jbremnant/project_ledi/doc/img/intro_assembled_android.jpg

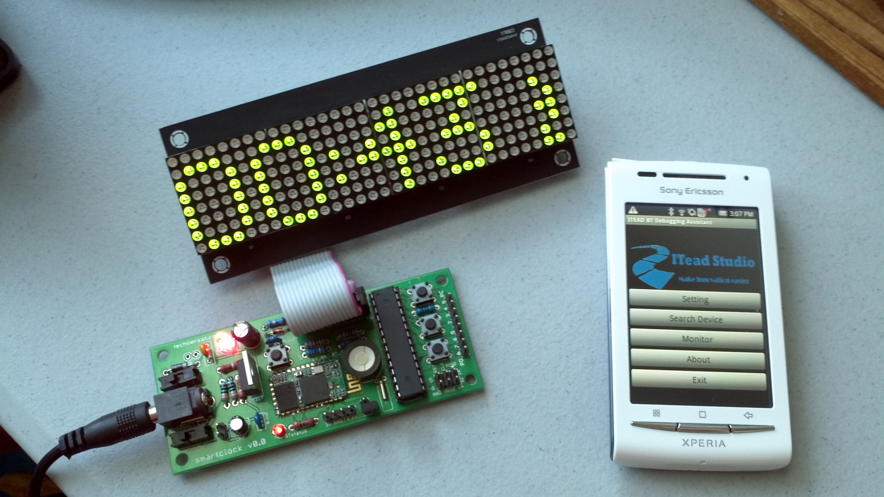
doc/img/intro_assembled_android.jpg
