jbremnant/project_ledi/doc/img/intro_pcb_assembled1.jpg

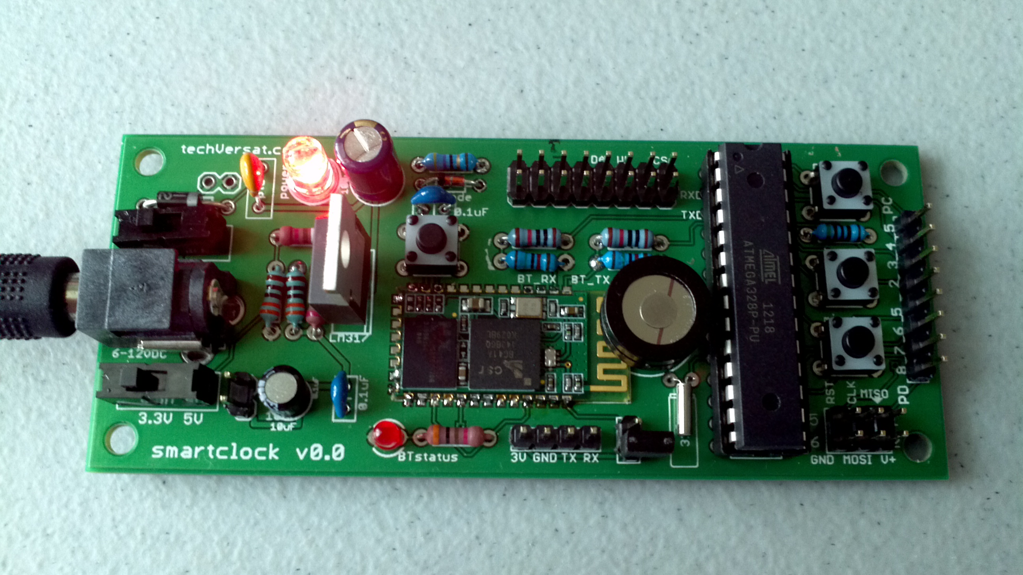
doc/img/intro_pcb_assembled1.jpg
