jbremnant/project_ledi/README.md

ledi
====

LED Interface (ledi) is an interactive LED display that can communicate with bluetooth devices as well as PC's
