jbremnant/project_ledi/doc/rst/page10_picgallery.rst

:title: LEDI Gallery
:id: 1721
:type: page
:parent_id: 1022

LEDI Gallery
============

Here are some customized LEDI enclosures we've created using LEGO blocks.
You can even print the adaptors using 3D printers to affix the PCB to the
LED matrix board.

White, Black, Gray Theme
------------------------







Office Theme
------------
With a hint of Starwars?







3D Printed Adaptors
-------------------
This was our prototype build using 3D printer.
