jbremnant/project_ledi/doc/rst/page09_takingfurther.rst

:title: 0x09 Project Ideas Using LEDI
:id: 1424
:type: page
:parent_id: 1022

0x09 Project Ideas Using LEDI
=============================

We designed LEDI to be flexible and open. We wanted to give as much control to 
the user on what and how they can modify to extend the device's functionality.
