jbremnant/project_ledi/doc/img/intro_side_by_side.jpg

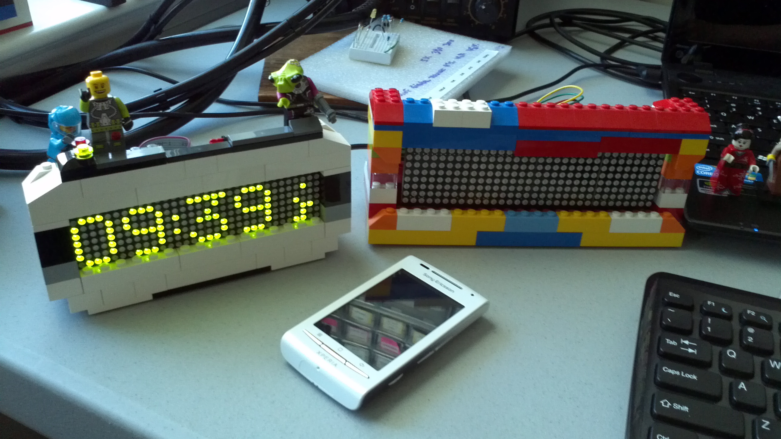
doc/img/intro_side_by_side.jpg
