jbremnant/project_ledi/doc/img/pcb_brd.png

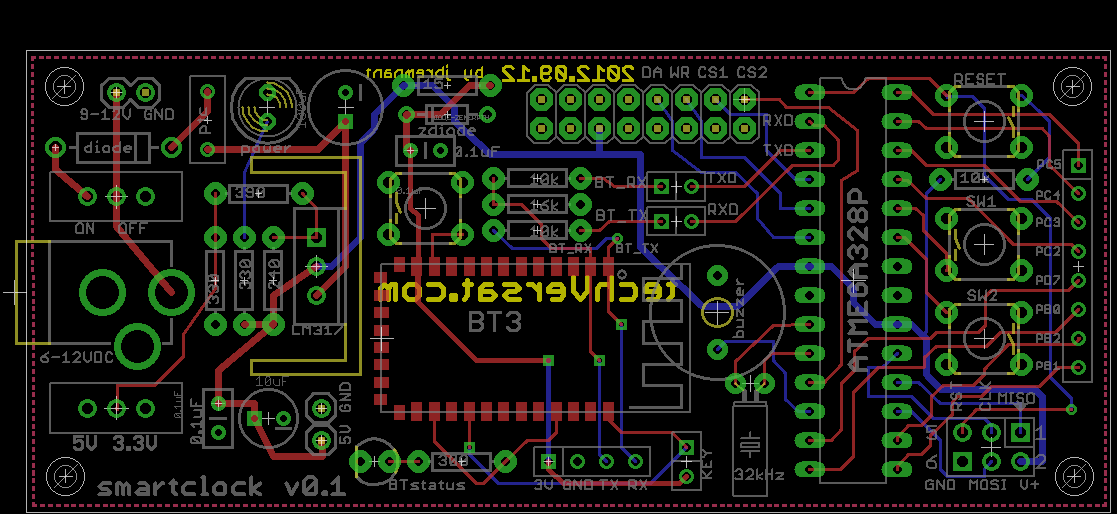
doc/img/pcb_brd.png
