jbremnant/project_ledi/doc/img/tut_pcb_close.jpg

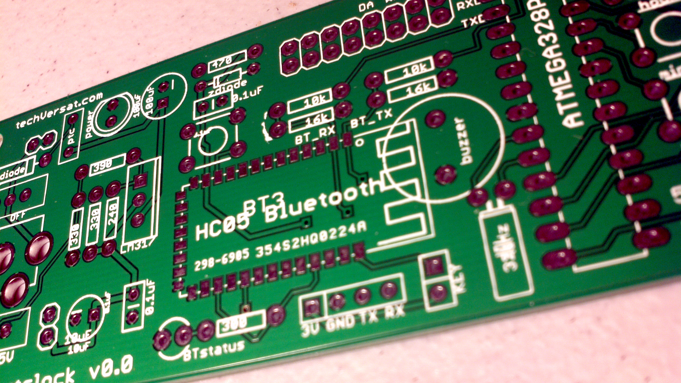
doc/img/tut_pcb_close.jpg
