jbremnant/project_ledi/doc/img/tut_parts01.jpg

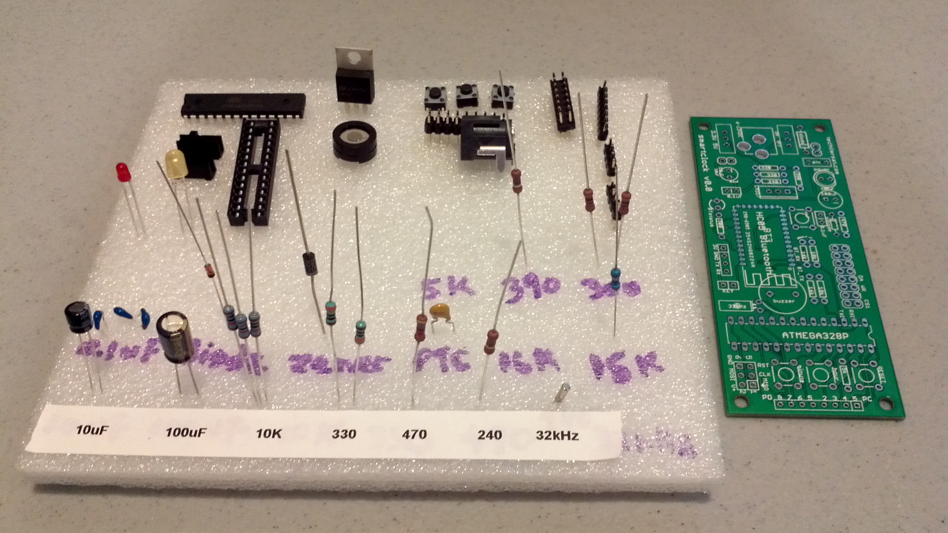
doc/img/tut_parts01.jpg
