jbremnant/project_ledi/doc/rst/page02_assembly.rst

:title: 0x02 Assembly Instructions
:id: 1400
:type: page
:parent_id: 1022

.. _`Back to top`:

0x02 Assembly Instructions
==========================

Just got your LEDI DIY kit, so what's next? 
In this page, we are going to show you:

* `What's Inside The Bag`_
* `Components Explaination`_
* `Tools Required`_
* `Soldering the Parts`_
* `Testing the Circuit`_
* `Assemblying the Acrylic Mount`_

What's Inside The Bag
----------------------



You should see the following items in your LEDI DIY kit package:

===========  =========  ==================================================  ==============
Name         Quantity   Description                                         Image
===========  =========  ==================================================  ==============
A1           1          32x8 LED matrix                                     
A2           1          Connector for LED matrix and PCB                    
B            1          `LEDI PCB`_                                         
C1,C2                   `Components List`_
C3           1          `Bluetooth module`_                                 
D            1          AC to 9V DC wall adaptor                            
===========  =========  ==================================================  ==============

Components List
~~~~~~~~~~~~~~~

=======================  =========  ==================================================  ==============
Name                     Quantity   Description                                         Image
=======================  =========  ==================================================  ==============
Atmega328p_              1          the brain of LEDI, microcontroller with 28 pins     
`28 pin DIP socket`_     1          socket for the microcontroller                      
`LDO Regulator`_         1          regulates 9VDC input into 5V or 3.3V                
`PTC resetable fuse`_    1          orange ceremic fuse .25A                            
`Crystal Oscillator`_    1          32.768KHz, silver cylinder shape                    
`Barrel jack`_           1          connector for AC adaptor                            
Slide switch             2          on/off, 3.3/5v switch                               
Tactile push button      4          buttons with 4 small legs                           
Capacitor_ 100uF         1          cylinder shape, aluminum, 2 leads                   
Capacitor_ 10uF          1          cylinder shape, aluminum, 2 leads                   
Capacitor_ 0.1uF         2          blue ceramic capacitor                              
`Zener Diode 3.3v`_      1          small orange component with black stripe            
Rectifier_ 1N4001        1          convert AC to DC current                            
Resistor_ 16k Ohms       1          ^strip colors: brown,blue,black,red                 
Resistor_ 10k Ohms       3          ^strip colors: brown,black,black,red                
Resistor_ 390 Ohms       1          ^strip colors: orange,white,brown                   
Resistor_ 330 Ohms       2          ^strip colors: orange,orange,black,black            
Resistor_ 300 Ohms       1          ^strip colors: orange,black,brown                   
Resistor_ 240 Ohms       1          ^strip colors: red,yellow,brown                     
Resistor_ 15  Ohms       1          ^strip colors: brown,green,black,gold               
LED_ Red                 1          red LED                                             
LED_ Amber               1          oval shape amber LED                                
Piezo Buzzer             1          makes sounds                                        
Header Single row        1          12 pins single row headers for breakout pins        
Header Dual row          1          2 x 15 header for connecting ribbon cable           
=======================  =========  ==================================================  ==============

.. _`Bluetooth module`: http://imall.iteadstudio.com/prototyping/basic-module/im120723009.html
.. _Atmega328p: http://www.atmel.com/devices/atmega328p.aspx
.. _`28 pin DIP socket`: http://en.wikipedia.org/wiki/Dual_in-line_package
.. _`LDO Regulator`: http://en.wikipedia.org/wiki/Low-dropout_regulator
.. _`PTC resetable fuse`: http://en.wikipedia.org/wiki/Resettable_fuse
.. _`Crystal Oscillator`: http://en.wikipedia.org/wiki/Crystal_oscillator
.. _`Barrel jack`: https://www.sparkfun.com/products/119

Resistors may come in different color and number of stripes depending on manufacturer,
the strip color specified above only indicates the resistor value portion.
Refer to the Resistor_ section to understand how to read the stripes value.

**If you are purchasing the acrylic mount**, the package should also include:

======================  =========  ==================================================  ==============
Name                    Quantity   Description                                         Image
======================  =========  ==================================================  ==============
Spacer 1/8"             4          1/8" length nylon spacers                           
Spacer 1/4"             4          2/8" length nylon spacers                           
Spacer 3/4"             4          6/8" length nylon spacers                           
Screw 1-1/2"            4          1-1/2" stainless steel screw                        
Screw 5/8               4          5/8" stainless steel screw                          
Nuts 4-40 thread        8          4-40 thread stainless steel hex nuts                
Acrylic front plate     1          Transparent acrylic plate for front cover           
Acrylic adaptor plate   2          Transparent acrylic adaptor                         
======================  =========  ==================================================  ==============

`Back to top`_

.. _Capacitor:

Components Explaination
-----------------------

Before assembly, let's make sure we have sufficient understanding about the components
used in this project, understanding this section will ensure successful completion of your build.

#. **Electrolytic Capacitor** (`wiki capacitor <http://en.wikipedia.org/wiki/Electrolytic_capacitor>`_)

    They look like aluminum cylinders wrapped in black plastic with one short and
   one long leg. Please note that **ORIENTATION MATTERS** while you are placing the component on the PCB. 
   **The short leg is the negative (-) terminal**. This negative terminal
   is also indicated on the plastic covering. The plastic cover will have a strip going
   down on the negative terminal side. In our design, negative terminal connects to GROUND.

.. _Rectifier:

#. **Reverse Voltage Protection Diode** (`wiki diode <http://en.wikipedia.org/wiki/Diode>`_) (`wiki rectifier <http://en.wikipedia.org/wiki/Rectifier>`_)

    This part looks like a small black cynlinder. It allows current to flow in one
   direction and not in the other. In this project, we are using the popular 1.0A
   general purpose silion rectifier diode - 1N4001, which serves as converter from AC to DC
   current. **ORIENTATION MATTERS** for all diodes. A small white strip on one end indicates the blocking side. 
   You will need to look at the PCB carefully and make sure the side with the strip is properly 
   aligned with the indicated strip on the PCB silkscreen (white labels on PCB).

.. _`Zener Diode 3.3v`:

#. **Zener Diode 3.3v** (`wiki zener diode <http://en.wikipedia.org/wiki/Zener_diode>`_)

    This part also looks like a cylinder, but in orange. It is similar to the diode
   described above, but allows current to flow in the reverse direction when the
   voltage is above a certain value. Therefore the **ORIENTATION MATTERS** for this component too.
   The black strip on one end indicates the "blocking" side. You will need to carefully match 
   this strip with the PCB silkscreen.

.. _LED:

#. **LED** (`light-emitting diode <http://en.wikipedia.org/wiki/LED>`_)

    One of the most common parts you can find in electronic kits or even at your
   local RadioShack, this part also has two legs - one short, one long. The short leg is the
   (-) terminal. Make sure the shorter leg connects to GROUND.

.. _Resistor:

#. **Resistor** (`wiki resistor <http://en.wikipedia.org/wiki/Resistor>`_)

    You will need to be careful about getting the resistor values right.
   Unlike other components discussed, the **orientation does NOT matter.** You can stick
   in the resistor in either direction onto the PCB. 
   Refer to the following resistor color code to determine their value:

   

   For example, if you see `red - yellow - black - orange`, you can read

::

    red   yellow  black  orange
      2        4      0      1k   ==  240k

Beside reading the color directly, it is always good to have a multimeter 
handy to measure the exact resistance. 

`Back to top`_

Tools Required
---------------

OK, now that you understanding the major components going into LEDI, let's talk about 
tools that you would need:

====================================  ====================
Tool                                  The Look
====================================  ====================
1. soldering_ iron                    
2. solder_ (Lead free preferable)     
3. flux_ (good to have)               
4. digital multimeter_ (optional)     
5. wire cutter_                       
6. solder wick_  (optional)           
7. solder sucker_ (optional)          
====================================  ====================

.. _flux: https://www.sparkfun.com/products/8967
.. _solder: https://www.sparkfun.com/products/9325
.. _soldering: http://www.adafruit.com/category/8_84
.. _multimeter: https://www.sparkfun.com/products/9141
.. _cutter: http://www.adafruit.com/products/152
.. _wick: http://www.adafruit.com/products/149
.. _sucker: http://www.adafruit.com/products/148

The flux, solder wick, and solder sucker are optional. However, they are good
tools to help ammend mistakes. If you are soldering for the first time, we
highly recommend getting those as well.

Here are the steps we will take

#. Organize the parts
#. Solder
#. Test the circuit
#. Install the app
#. Play with it!

If you've never soldered before, it might be good to do some prep reading or
even prep practice before you go into touching the components. It's easy to solder but 
hard to take out sometime.
There are lots of great videos and tutorials online. Here are few:

* `Sparkfun tutorial <http://www.sparkfun.com/tutorials/106>`_.
* `Adafruit tutorial <http://www.ladyada.net/learn/soldering/thm.html>`_.
* `Soldering tutorial at aaroncake.net <http://www.aaroncake.net/electronics/solder.htm>`_

`Back to top`_

Soldering the Parts
-------------------

Through-hole soldering is pretty fun and straight forward! Make sure you work in a well ventilated room.
Now, all you need is some solder and a soldering iron. When we are done with the
assembly, your LEDI board will look like this:



The parts are easier to find once you organize them. It's good to label similar
looking parts beforehand, so you know exactly which part you are going to solder.
For example, here's how I organized the parts before soldering.



It's good to complete similar parts of the circuit and then move onto the next. 
This way, you can make sure you got all the parts soldered in the right place,
instead of jumping around the circuit. (not literally!)

.. _`LEDI PCB`:

LEDI circuit can be roughly divided into 4 sections. We will complete each section
at a time before moving onto the next. 



You will soon see that soldering LEDI board is easy and straight-forward.

Power supply circuit
~~~~~~~~~~~~~~~~~~~~
You will need to be careful about the polarity of the electrolyte capacitors.
The shorter leg is the negative side. It's this shorter leg that will connect
to ground. The same goes for the power indicator LED. The shorter leg connects
to the ground through-hole, which is denoted with a minus "-" sign.



Here's how I placed the parts before soldering. Notice the legs are bent on the
other side of the PCB so that they are held stationary as I solder them permanently
in place.



Bluetooth module
~~~~~~~~~~~~~~~~
The bluetooth module is the hardest part to solder. You will find that the rest of
what follows is a breeze. First place the bluetooth module on the PCB.
You will solder just one pad on each side first. This will hold the module in place.

You will only need to solder 11 joints on the module. The rest of the pads does not need 
to be soldered. Those 11 joints are indicated by orange circle below:



If you have the flux handy, it helps the solder to flow onto the pads easily.
You can use it to "tin" the pads by

#. applying little bit of flux onto the PCB pads
#. put some solder on the soldering iron, and gently pass it over the pads

At this point, the solder will flow to the pads and settle. Once the pads are tinned
with solder, you can simply set the bluetooth module on top, and touch the pad to
reflow the solder onto the bluetooth connection grooves.

Once the bluetooth module is soldered, solder the indicator LED and resistors 
around the bluetooth module. The headers are optional, unless you plan to hack around
with LEDI later on.

Zener diode voltage regulator circuit 
~~~~~~~~~~~~~~~~~~~~~~~~~~~~~~~~~~~~~
It's crucial to get the resistor value right here. You will need 15 Ohm (not 15k!!!)
resistor, a zener diode, and a 0.1uF capacitor. As a reminder, resistor strip colors are::
     
      1     5    0x  tolerance  ==  15 ohm
  brown green black  gold

The zener diode need special attention as well. Make sure you align the black strip
side with the side that has white line on the PCB. It should look like the following picture.



You can then add the push button that will allow you to reset the bluetooth module.
Optionally, you can add the headers that will give you access to the bluetooth module's UART ports.

After this circuit is built, you are ready to do your first test! Simply plug in the 9V
power adaptor to the wall, and connect the barrel jack to the board. Take a deep breath
and turn the switch to "on" position!

Do you see the power LED light up and the indicator LED near the bluetooth module
blinking? If so, you are on your way to getting it successfully built!
If not, you will need to check your components and make sure you soldered the
parts correctly.

Atmega328p microcontroller and headers
~~~~~~~~~~~~~~~~~~~~~~~~~~~~~~~~~~~~~~
This is the easiest part of the circuit. You have one pull up resistor (10k ohm), 3 buttons,
watch crystal (32.768kHz) and IC socket. The microcontroller will be inserted into the IC
socket once everything is soldered in place.



The 2x3 header on the bottom right corner is a must if you plan on flashing the firmware.
By default, LEDI will come preloaded with the most recent firmware. However, if you plan
on doing firmware development and modify functionality, solder the 2x3 header there.

Also, the 1x8 header gives you access to unused I/O pins on the microcontroller. Solder this
too if you want to make LEDI interface with other electronics.

`Back to top`_

Testing the Circuit
-------------------

Now you are finally ready to test the whole thing!
Let's first connect the LED matrix to the circuit board.

Note that the ribbon cable has a red strip on one end. The red strip denotes the first pin.
Align this with the pin labelled CS1 on the circuit board.
The PCB side of the ribbon cable connection looks like this:



Don't mind the other device on the picture right now (`little wire <http://littlewire.cc/>`_) -
this device can help flash the firmware of LEDI.

Connect the other side of the ribbon cable to the LED matrix. Make sure your DIP switch on the
LED matrix board looks like this:

.. leesa, picture of the 1,2,3,4 switch on the backside of LED board

Once connected, time to power it on!
Connect the included 9VDC adaptor to the barrel jack, and plug it to the wall outlet.
Now, take a deep breath again and switch the power to **on**.
Did you see the sign "LEDI" on the LED matrix board? If so, congratulations!
You have successfully assembled LEDI.

There's so much more to play around with. Check out our other tutorials to explore many
exciting projects with LEDI.

Assemblying the Acrylic Mount
-----------------------------
Now that the PCB and LED matrix work well, time to put a little cosmetic on it. Depending on your personl preference, you can 

#. Just leave the parts on your desk.
#. Put the parts together with our customed made acrylic mount.
#. Use bricks to make the LEDI into a piece of artwork. 
#. Or even print your own mount or enclosure if you have a 3D printer.

If you opt to use our customed made acrylic mount, here's the detail instruction for the assembly.

`Back to top`_





























 
.. parts list

   :uploaded-scale10: http://techversat.com/wp-content/uploads/ledi/parts_ledi_MCU-scale10.jpg
   :uploaded: http://techversat.com/wp-content/uploads/ledi/parts_ledi_MCU.jpg
   :width: 1000
   :scale: 10

   :uploaded-scale10: http://techversat.com/wp-content/uploads/ledi/parts_ledi_DIPSocket-scale5.jpg
   :uploaded: http://techversat.com/wp-content/uploads/ledi/parts_ledi_DIPSocket.jpg
   :width: 1000
   :scale: 10

   :uploaded-scale10: http://techversat.com/wp-content/uploads/ledi/parts_ledi_PCB-v1-scale10.jpg
   :uploaded: http://techversat.com/wp-content/uploads/ledi/parts_ledi_PCB-v1.jpg
   :width: 1000
   :scale: 10

   :uploaded-scale10: http://techversat.com/wp-content/uploads/ledi/parts_ledi_BTModule-scale10.jpg
   :uploaded: http://techversat.com/wp-content/uploads/ledi/parts_ledi_BTModule.jpg
   :width: 1000
   :scale: 10

   :uploaded-scale10: http://techversat.com/wp-content/uploads/ledi/parts_ledi_VRegulator-scale10.jpg
   :uploaded: http://techversat.com/wp-content/uploads/ledi/parts_ledi_VRegulator.jpg
   :width: 1000
   :scale: 10

   :uploaded-scale10: http://techversat.com/wp-content/uploads/ledi/parts_ledi_PTC-scale10.jpg
   :uploaded: http://techversat.com/wp-content/uploads/ledi/parts_ledi_PTC.jpg
   :width: 1000
   :scale: 10

   :uploaded-scale10: http://techversat.com/wp-content/uploads/ledi/parts_ledi_Crystal-scale10.jpg
   :uploaded: http://techversat.com/wp-content/uploads/ledi/parts_ledi_Crystal.jpg
   :width: 1000
   :scale: 10

   :uploaded-scale10: http://techversat.com/wp-content/uploads/ledi/parts_ledi_BarrelJack-scale10.jpg
   :uploaded: http://techversat.com/wp-content/uploads/ledi/parts_ledi_BarrelJack1.jpg
   :width: 1000
   :scale: 10

   :uploaded-scale10: http://techversat.com/wp-content/uploads/ledi/parts_ledi_SlideSwitch-scale10.jpg
   :uploaded: http://techversat.com/wp-content/uploads/ledi/parts_ledi_SlideSwitch.jpg
   :width: 1000
   :scale: 10

   :uploaded-scale10: http://techversat.com/wp-content/uploads/ledi/parts_ledi_ButtonSwitch-scale10.jpg
   :uploaded: http://techversat.com/wp-content/uploads/ledi/parts_ledi_ButtonSwitch.jpg
   :width: 1000
   :scale: 10

   :uploaded-scale10: http://techversat.com/wp-content/uploads/ledi/parts_ledi_Capacitor-100uF-scale10.jpg
   :uploaded: http://techversat.com/wp-content/uploads/ledi/parts_ledi_Capacitor-100uF.jpg
   :width: 1000
   :scale: 10

   :uploaded-scale10: http://techversat.com/wp-content/uploads/ledi/parts_ledi_Capacitor-10uF-scale10.jpg
   :uploaded: http://techversat.com/wp-content/uploads/ledi/parts_ledi_Capacitor-10uF.jpg
   :width: 1000
   :scale: 10

   :uploaded-scale10: http://techversat.com/wp-content/uploads/ledi/parts_ledi_Capacitor-0.1uF-scale10.jpg
   :uploaded: http://techversat.com/wp-content/uploads/ledi/parts_ledi_Capacitor-0.1uF.jpg
   :width: 1000
   :scale: 10

   :uploaded-scale10: http://techversat.com/wp-content/uploads/ledi/parts_ledi_Zener-3.3V-scale10.jpg
   :uploaded: http://techversat.com/wp-content/uploads/ledi/parts_ledi_Zener-3.3V.jpg
   :width: 1000
   :scale: 10

   :uploaded-scale10: http://techversat.com/wp-content/uploads/ledi/parts_ledi_1N4001-scale10.jpg
   :uploaded: http://techversat.com/wp-content/uploads/ledi/parts_ledi_1N4001.jpg
   :width: 1000
   :scale: 10

   :uploaded-scale10: http://techversat.com/wp-content/uploads/ledi/parts_ledi_Resistor-16KOhm-scale10.jpg
   :uploaded: http://techversat.com/wp-content/uploads/ledi/parts_ledi_Resistor-16KOhm.jpg
   :width: 1000
   :scale: 10

   :uploaded-scale10: http://techversat.com/wp-content/uploads/ledi/parts_ledi_Resistor-10KOhm-scale10.jpg
   :uploaded: http://techversat.com/wp-content/uploads/ledi/parts_ledi_Resistor-10KOhm.jpg
   :width: 1000
   :scale: 10

   :uploaded-scale10: http://techversat.com/wp-content/uploads/ledi/parts_ledi_Resistor-390Ohm-scale10.jpg
   :uploaded: http://techversat.com/wp-content/uploads/ledi/parts_ledi_Resistor-390Ohm.jpg
   :width: 1000
   :scale: 10

   :uploaded-scale10: http://techversat.com/wp-content/uploads/ledi/parts_ledi_Resistor-330Ohm-scale10.jpg
   :uploaded: http://techversat.com/wp-content/uploads/ledi/parts_ledi_Resistor-330Ohm.jpg
   :width: 1000
   :scale: 10

   :uploaded-scale10: http://techversat.com/wp-content/uploads/ledi/parts_ledi_Resistor-300Ohm-scale10.jpg
   :uploaded: http://techversat.com/wp-content/uploads/ledi/parts_ledi_Resistor-300Ohm.jpg
   :width: 1000
   :scale: 10

   :uploaded-scale10: http://techversat.com/wp-content/uploads/ledi/parts_ledi_Resistor-240Ohm-scale10.jpg
   :uploaded: http://techversat.com/wp-content/uploads/ledi/parts_ledi_Resistor-240Ohm.jpg
   :width: 1000
   :scale: 10

   :uploaded-scale10: http://techversat.com/wp-content/uploads/ledi/parts_ledi_Resistor-15Ohm-scale10.jpg
   :uploaded: http://techversat.com/wp-content/uploads/ledi/parts_ledi_Resistor-15Ohm.jpg
   :width: 1000
   :scale: 10

   :uploaded-scale10: http://techversat.com/wp-content/uploads/ledi/parts_ledi_LED-Yellow-scale10.jpg
   :uploaded: http://techversat.com/wp-content/uploads/ledi/parts_ledi_LED-Yellow.jpg
   :width: 1000
   :scale: 10

   :uploaded-scale10: http://techversat.com/wp-content/uploads/ledi/parts_ledi_LED-Red-scale10.jpg
   :uploaded: http://techversat.com/wp-content/uploads/ledi/parts_ledi_LED-Red.jpg
   :width: 1000
   :scale: 10

   :uploaded-scale10: http://techversat.com/wp-content/uploads/ledi/parts_ledi_Buzz-scale10.jpg
   :uploaded: http://techversat.com/wp-content/uploads/ledi/parts_ledi_Buzz.jpg
   :width: 1000
   :scale: 10

   :uploaded-scale10: http://techversat.com/wp-content/uploads/ledi/parts_ledi_WallAdaptor-AC-9VDC-scale10.jpg
   :uploaded: http://techversat.com/wp-content/uploads/ledi/parts_ledi_WallAdaptor-AC-9VDC.jpg
   :width: 1000
   :scale: 10

   :uploaded-scale10: http://techversat.com/wp-content/uploads/ledi/parts_ledi_SingleHeader-scale10.jpg
   :uploaded: http://techversat.com/wp-content/uploads/ledi/parts_ledi_SingleHeader.jpg
   :width: 1000
   :scale: 10

   :uploaded-scale10: http://techversat.com/wp-content/uploads/ledi/parts_ledi_DualHeader-scale10.jpg
   :uploaded: http://techversat.com/wp-content/uploads/ledi/parts_ledi_DualHeader.jpg
   :width: 1000
   :scale: 10

   :uploaded-scale10: http://techversat.com/wp-content/uploads/ledi/parts_ledi_LEDMatrix-32x8-scale10.jpg
   :uploaded: http://techversat.com/wp-content/uploads/ledi/parts_ledi_LEDMatrix-32x8.jpg
   :width: 1000
   :scale: 10

   :uploaded-scale10: http://techversat.com/wp-content/uploads/ledi/parts_ledi_Connector-LEDMatrix-PCB-scale10.jpg
   :uploaded: http://techversat.com/wp-content/uploads/ledi/parts_ledi_Connector-LEDMatrix-PCB.jpg
   :width: 1000
   :scale: 10

   :uploaded-scale10: http://techversat.com/wp-content/uploads/ledi/parts_lediAcrylic_Spacer-1-4-scale10.jpg
   :uploaded: http://techversat.com/wp-content/uploads/ledi/parts_lediAcrylic_Spacer-1-4.jpg
   :width: 1000
   :scale: 10

   :uploaded-scale10: http://techversat.com/wp-content/uploads/ledi/parts_lediAcrylic_Spacer-1-8-scale10.jpg
   :uploaded: http://techversat.com/wp-content/uploads/ledi/parts_lediAcrylic_Spacer-1-8.jpg
   :width: 1000
   :scale: 10

   :uploaded-scale10: http://techversat.com/wp-content/uploads/ledi/parts_lediAcrylic_Spacer-3-4-scale10.jpg
   :uploaded: http://techversat.com/wp-content/uploads/ledi/parts_lediAcrylic_Spacer-3-4.jpg
   :width: 1000
   :scale: 10

   :uploaded-scale10: http://techversat.com/wp-content/uploads/ledi/parts_lediAcrylic_Screw-1.5-scale10.jpg
   :uploaded: http://techversat.com/wp-content/uploads/ledi/parts_lediAcrylic_Screw-1.5.jpg
   :width: 1000
   :scale: 10

   :uploaded-scale10: http://techversat.com/wp-content/uploads/ledi/parts_lediAcrylic_Screw-5-8-scale10.jpg
   :uploaded: http://techversat.com/wp-content/uploads/ledi/parts_lediAcrylic_Screw-5-8.jpg
   :width: 1000
   :scale: 10

   :uploaded-scale10: http://techversat.com/wp-content/uploads/ledi/parts_lediAcrylic_Nut-4-40-scale10.jpg
   :uploaded: http://techversat.com/wp-content/uploads/ledi/parts_lediAcrylic_Nut-4-40.jpg
   :width: 1000
   :scale: 10

   :uploaded-scale10: http://techversat.com/wp-content/uploads/ledi/parts_lediAcrylic_FrontCover-scale10.jpg
   :uploaded: http://techversat.com/wp-content/uploads/ledi/parts_lediAcrylic_FrontCover.jpg
   :width: 1000
   :scale: 10

   :uploaded-scale10: http://techversat.com/wp-content/uploads/ledi/parts_lediAcrylic_Adaptor-scale10.jpg
   :uploaded: http://techversat.com/wp-content/uploads/ledi/parts_lediAcrylic_Adaptor.jpg
   :width: 1000
   :scale: 10

   :uploaded-scale10: http://techversat.com/wp-content/uploads/ledi/parts_ledi_Capacitor-100uF-scale10.jpg
   :uploaded: http://techversat.com/wp-content/uploads/ledi/parts_ledi_Capacitor-100uF.jpg
   :scale: 10

   :uploaded-scale10: http://techversat.com/wp-content/uploads/ledi/parts_ledi_1N4001-scale10.jpg
   :uploaded: http://techversat.com/wp-content/uploads/ledi/parts_ledi_1N4001.jpg
   :scale: 10

   :uploaded-scale10: http://techversat.com/wp-content/uploads/ledi/parts_ledi_Zener-3.3V-scale10.jpg
   :uploaded: http://techversat.com/wp-content/uploads/ledi/parts_ledi_Zener-3.3V.jpg
   :scale: 10

   :uploaded-scale10: http://techversat.com/wp-content/uploads/ledi/parts_ledi_LED-Red-scale10.jpg
   :uploaded: http://techversat.com/wp-content/uploads/ledi/parts_ledi_LED-Red.jpg
   :scale: 10

   :uploaded-scale10: http://techversat.com/wp-content/uploads/ledi/parts_ledi_Resistor-15Ohm-scale10.jpg
   :uploaded: http://techversat.com/wp-content/uploads/ledi/parts_ledi_Resistor-15Ohm.jpg
   :scale: 10
