jbremnant/project_ledi/hw/v0.0/sc_v0.brd

## EAGLE design hw/v0.0/sc_v0.brd (2012-11-04)

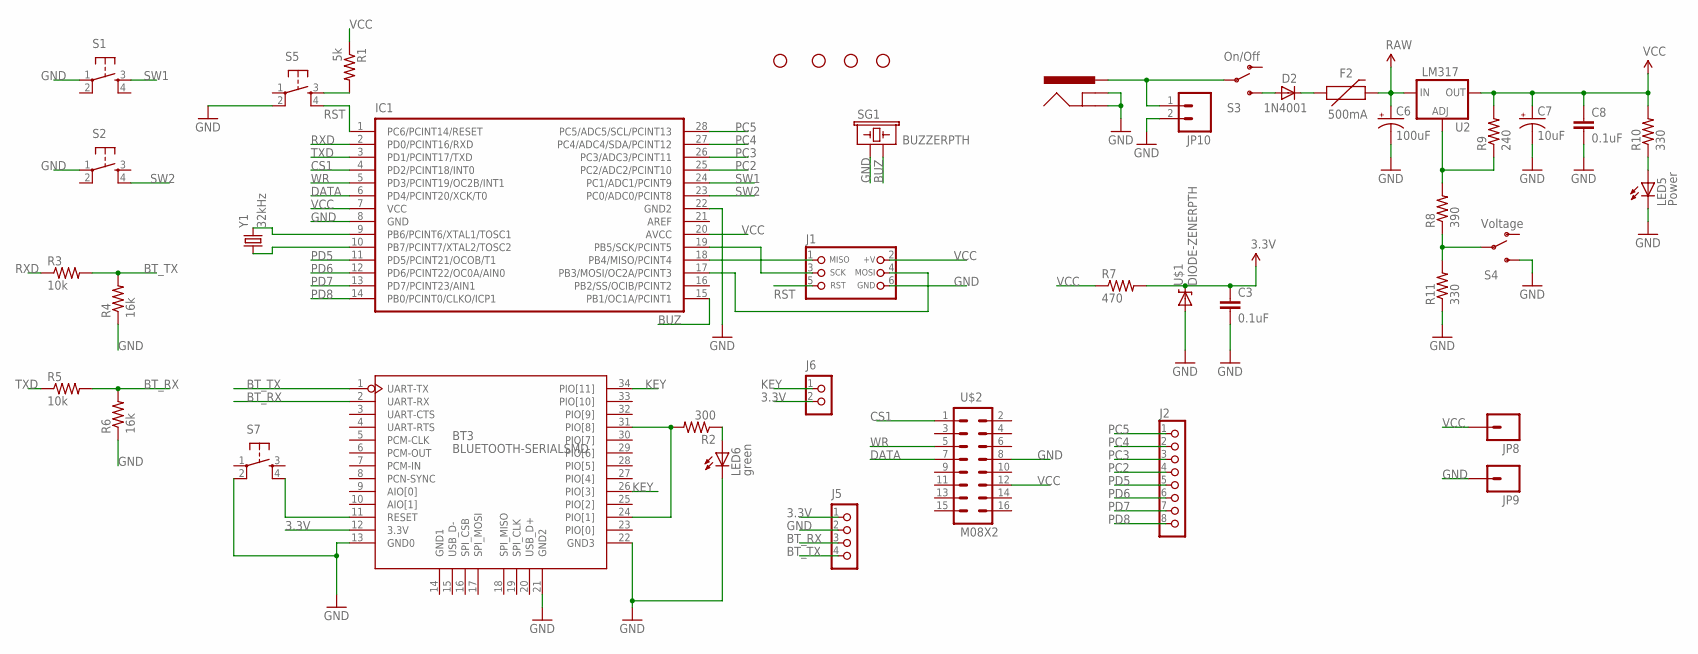
[picture p10: schematic sc_v0.sch]

Parts:
BT3: BLUETOOTH-SERIALSMD; SERIAL_BLUETEETH
C3, C8: 0.1uF; CAP-PTH-SMALL2
C6: 100uF; CPOL-RADIAL-100UF-25V
C7: 10uF; CPOL-RADIAL-10UF-25V
D2: 1N4001; DIODE-0.4
F2: 500mA; PTC
IC1: IC_UC_ATMEGA328PDIL; DIL28-N
J1: CON_HEADER_PRG_AVR_ICSP; HEADER_PRG_2X03
J2: CON_HEADER_1X08-PTH; M1X8
J3: POWER_JACKPTH; POWER_JACK_PTH
J5: CON_HEADER_1X04; M1X4
J6: CON_HEADER_1X02-PTH; M1X2
JP1, JP2, JP3, JP4: STAND-OFF
JP8, JP9: M01PTH; 1X01
JP10: M02PTH; 1X02
LED5: Power; LED5MM
LED6: green; LED3MM
R1: 5k; AXIAL-0.3
R2: 300; AXIAL-0.3
R3, R5: 10k; AXIAL-0.3
R4, R6: 16k; AXIAL-0.3
R7: 470; AXIAL-0.3
R8: 390; AXIAL-0.3
R9: 240; AXIAL-0.3
R10, R11: 330; AXIAL-0.3
S1, S2, S5, S7: TAC_SWITCHPTH; TACTILE-PTH
S3: On/Off; SWITCH-SPST
S4: Voltage; SWITCH-SPST
SG1: BUZZERPTH; BUZZER-12MM
U2: LM317; TO220-ADJ
U$1: DIODE-ZENERPTH; DIODE-ZENER
U$2: M08X2; 2X8
Y1: 32kHz; TC38H

Connections:
3.3V: BT3.12 (3.3V), C3.1, J5.1, J6.2, R7.P$2 (2), U$1.P$1 (C)
BT_RX: BT3.2 (UART-RX), J5.3, R5.P$2 (2), R6.P$2 (2)
BT_TX: BT3.1 (UART-TX), J5.4, R3.P$2 (2), R4.P$2 (2)
BUZ: IC1.15 (PB1/OC1A/PCINT1), SG1.- (2)
CS1: IC1.4 (PD2/PCINT18/INT0), U$2.1
DATA: IC1.6 (PD4/PCINT20/XCK/T0), U$2.7
GND: BT3.13 (GND0), BT3.21 (GND2), BT3.22 (GND3), C3.2, C6.2 (-), C7.2 (-), C8.2, IC1.8 (GND), IC1.22 (GND2), J1.6 (GND), J3.GND, J3.GNDBREAK, J5.2, JP9.1, JP10.2, LED5.K (C), LED6.K (C), R4.P$1 (1), R6.P$1 (1), R11.P$1 (1), S1.1, S2.1, S4.3 (S), S5.2, S7.2, SG1.+ (1), U$1.P$2 (A), U$2.8
KEY: BT3.26 (PIO[3]), BT3.34 (PIO[11]), J6.1
unnamed: IC1.9 (PB6/PCINT6/XTAL1/TOSC1), Y1.2
unnamed: IC1.10 (PB7/PCINT7/XTAL2/TOSC2), Y1.1
unnamed: IC1.18 (PB4/MISO/PCINT4), J1.1 (MISO)
unnamed: IC1.19 (PB5/SCK/PCINT5), J1.3 (SCK)
unnamed: IC1.17 (PB3/MOSI/OC2A/PCINT3), J1.4 (MOSI)
unnamed: R8.P$2 (2), R9.P$1 (1), U2.ADJ
unnamed: LED5.A, R10.P$1 (1)
unnamed: BT3.24 (PIO[1]), BT3.31 (PIO[8]), R2.P$2 (2)
unnamed: D2.C, F2.P$1 (1)
unnamed: D2.A, S3.3 (S)
unnamed: J3.PWR, JP10.1, S3.2
unnamed: R8.P$1 (1), R11.P$2 (2), S4.2
unnamed: R1.P$2 (2), S5.3
unnamed: BT3.11 (RESET), S7.4
unnamed: LED6.A, R2.P$1 (1)
PC2: IC1.25 (PC2/ADC2/PCINT10), J2.4
PC3: IC1.26 (PC3/ADC3/PCINT11), J2.3
PC4: IC1.27 (PC4/ADC4/SDA/PCINT12), J2.2
PC5: IC1.28 (PC5/ADC5/SCL/PCINT13), J2.1
PD5: IC1.11 (PD5/PCINT21/OCOB/T1), J2.5
PD6: IC1.12 (PD6/PCINT22/OC0A/AIN0), J2.6
PD7: IC1.13 (PD7/PCINT23/AIN1), J2.7
PD8: IC1.14 (PB0/PCINT0/CLKO/ICP1), J2.8
RAW: C6.1 (+), F2.P$2 (2), U2.IN
RST: IC1.1 (PC6/PCINT14/RESET), J1.5 (RST), S5.4
RXD: IC1.2 (PD0/PCINT16/RXD), R3.P$1 (1)
SW1: IC1.24 (PC1/ADC1/PCINT9), S1.3
SW2: IC1.23 (PC0/ADC0/PCINT8), S2.4
TXD: IC1.3 (PD1/PCINT17/TXD), R5.P$1 (1)
VCC: C7.1 (+), C8.1, IC1.7 (VCC), IC1.20 (AVCC), J1.2 (+V), JP8.1, R1.P$1 (1), R7.P$1 (1), R9.P$2 (2), R10.P$2 (2), U2.OUT, U$2.12
WR: IC1.5 (PD3/PCINT19/OC2B/INT1), U$2.5

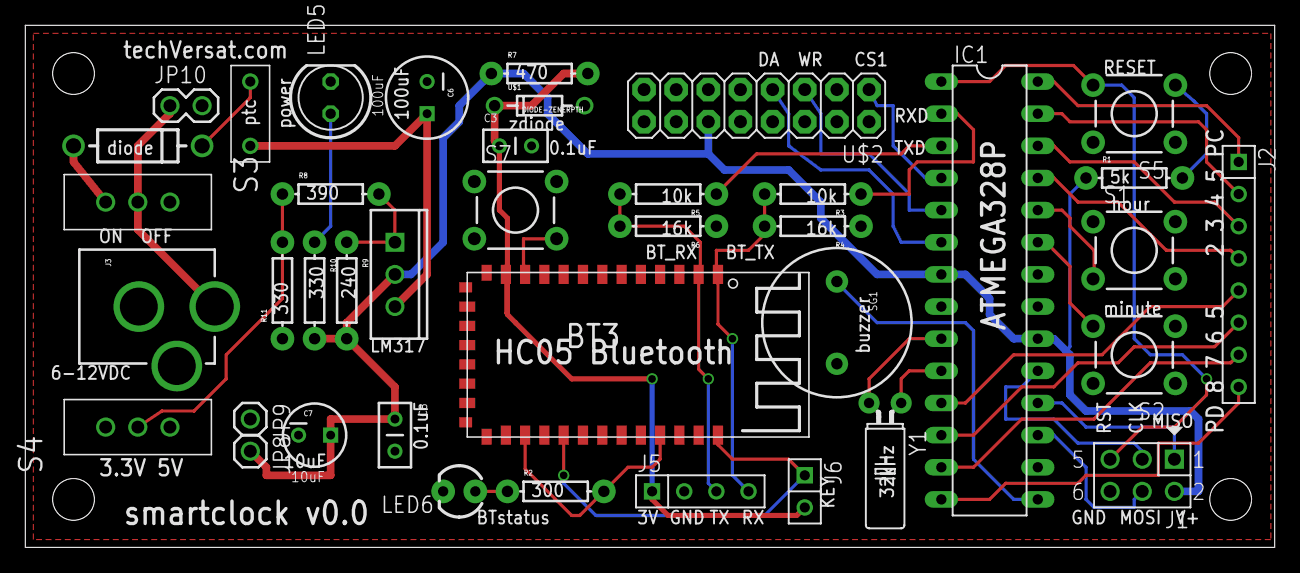
[picture p11: board sc_v0.brd from above]

Board: 2 copper layers, 98.7 x 41.3 mm, 44 parts (0 on the bottom side), 39 nets.
