jbremnant/project_ledi/(commit log)

2012-11-11 uart default speed at 9600. suppressed all debug output via uart - it messes up the data flow
2012-11-12 first placeholder for LEDI
2012-11-26 changed assembly instruction
2012-11-29 add parts for the assembly
2012-12-09 finished the assembly tutorial
2012-12-21 ledi android app
